marcobockelbrink/einfachstoppen-tor/docs/amazon.md

# Einkaufsliste (Suchlinks, keine Partnerlinks)

> **Es gibt hier keine Partnerlinks und es wird nichts daran verdient.** Die Links sind
> gewöhnliche Amazon-Suchen, damit man die Teile schneller findet. Wer sie nachbaut, kauft
> dort, wo er will.

Teile und Mengen: [teileliste.md](teileliste.md). Ich habe **keine einzelnen Produkte**
ausgewählt, weil ich Amazon-Seiten nicht abrufe und Preise, Händler und Verfügbarkeit
wechseln. Wähle je Zeile ein Angebot mit guten Bewertungen aus.

| Teil | Suchbegriff | Menge | Link |
| --- | --- | --- | --- |
| ESP32-C3 SuperMini | `ESP32-C3 SuperMini` | 2 | [suchen](https://www.amazon.de/s?k=ESP32-C3+SuperMini) |
| IR-Empfänger | `TSOP4838 IR Empfänger 38kHz` | 1 | [suchen](https://www.amazon.de/s?k=TSOP4838+IR+Empf%C3%A4nger+38kHz) |
| IR-LED 940 nm | `IR LED 940nm 5mm` | 1 | [suchen](https://www.amazon.de/s?k=IR+LED+940nm+5mm) |
| Transistor | `BC337 Transistor NPN` | 1 | [suchen](https://www.amazon.de/s?k=BC337+Transistor+NPN) |
| Widerstände | `Widerstand Sortiment 1/4W` | 1 Set | [suchen](https://www.amazon.de/s?k=Widerstand+Sortiment+1%2F4W) |
| Powerbank | `Powerbank klein 5000mAh` | 2 | [suchen](https://www.amazon.de/s?k=Powerbank+klein+5000mAh) |
| USB-C-Kabel kurz | `USB C Kabel 0,5m` | 2 | [suchen](https://www.amazon.de/s?k=USB+C+Kabel+0%2C5m) |
| Mutter 1/4″ | `Mutter 1/4 UNC 20 Stativ` | 2 | [suchen](https://www.amazon.de/s?k=Mutter+1%2F4+UNC+20+Stativ) |
| Blechschrauben | `Blechschrauben M3 Sortiment` | 1 Set | [suchen](https://www.amazon.de/s?k=Blechschrauben+M3+Sortiment) |
| Schrumpfschlauch | `Schrumpfschlauch schwarz 6mm` | 1 | [suchen](https://www.amazon.de/s?k=Schrumpfschlauch+schwarz+6mm) |
| Steckbrett und Jumperkabel | `Breadboard Jumper Kabel Set` | 1 | [suchen](https://www.amazon.de/s?k=Breadboard+Jumper+Kabel+Set) |
| Mini-Stativ | `Handy Stativ 1/4 Zoll` | 2 | [suchen](https://www.amazon.de/s?k=Handy+Stativ+1%2F4+Zoll) |

Für den Startstab ([startstab.md](startstab.md), Teile S2 bis S11):

| Teil | Suchbegriff | Menge | Link |
| --- | --- | --- | --- |
| Reedkontakt | `Reed Schalter Glas Schließer` | 1 | [suchen](https://www.amazon.de/s?k=Reed+Schalter+Glas+Schlie%C3%9Fer) |
| Scheibenmagnet | `Neodym Magnet Scheibe 8x3` | 1 | [suchen](https://www.amazon.de/s?k=Neodym+Magnet+Scheibe+8x3) |
| Rundstab | `Rundstab Holz 12mm` | 1 | [suchen](https://www.amazon.de/s?k=Rundstab+Holz+12mm) |
| Zugfeder | `Zugfeder Set klein` | 1 | [suchen](https://www.amazon.de/s?k=Zugfeder+Set+klein) |
| Holzschrauben | `Holzschrauben 3x20` | 1 Set | [suchen](https://www.amazon.de/s?k=Holzschrauben+3x20) |
| Scharnier | `Scharnier klein Edelstahl` | 1 | [suchen](https://www.amazon.de/s?k=Scharnier+klein+Edelstahl) |
| Sekundenkleber | `Sekundenkleber` | 1 | [suchen](https://www.amazon.de/s?k=Sekundenkleber) |

Die Suchbegriffe sind Vorschläge, nicht geprüft. Es lohnt sich, bei den Elektronikteilen
auch bei einem Elektronikhändler (z. B. Reichelt) zu schauen; dort ist das Datenblatt
meist verlinkt, was bei Sammelangeboten fehlt.
