marcobockelbrink/einfachstoppen-tor/gehaeuse/stl/stab_magnethalter.stl

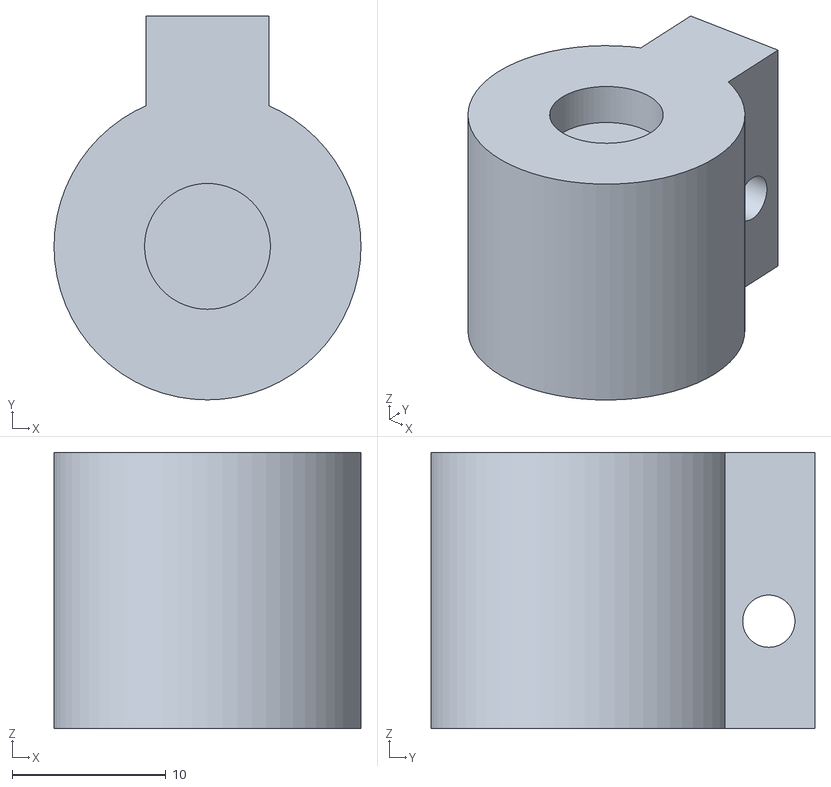
[picture p1: CAD file, 2026-10-12]
gehaeuse/stl/stab_magnethalter.stl
20.0 x 25.0 x 18.0
