marcobockelbrink/einfachstoppen-tor/gehaeuse/stl/stab_reedhalter.stl

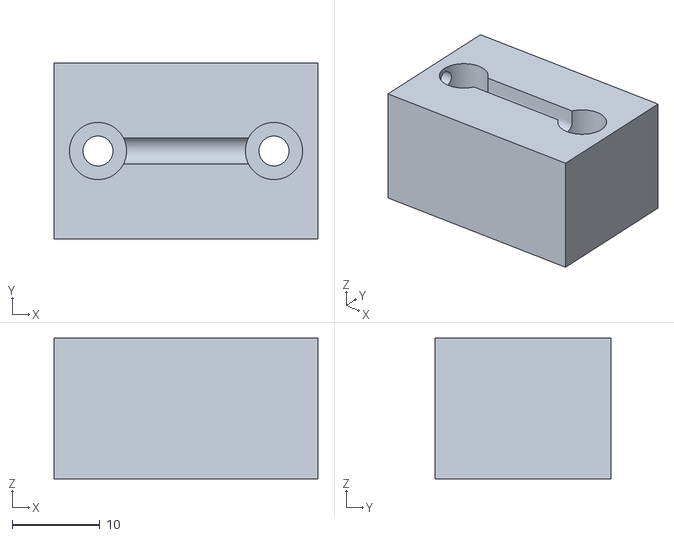
[picture p2: CAD file, 2026-10-12]
gehaeuse/stl/stab_reedhalter.stl
30.0 x 20.0 x 16.0
