marcobockelbrink/einfachstoppen-tor/gehaeuse/stl/stab_unten.stl

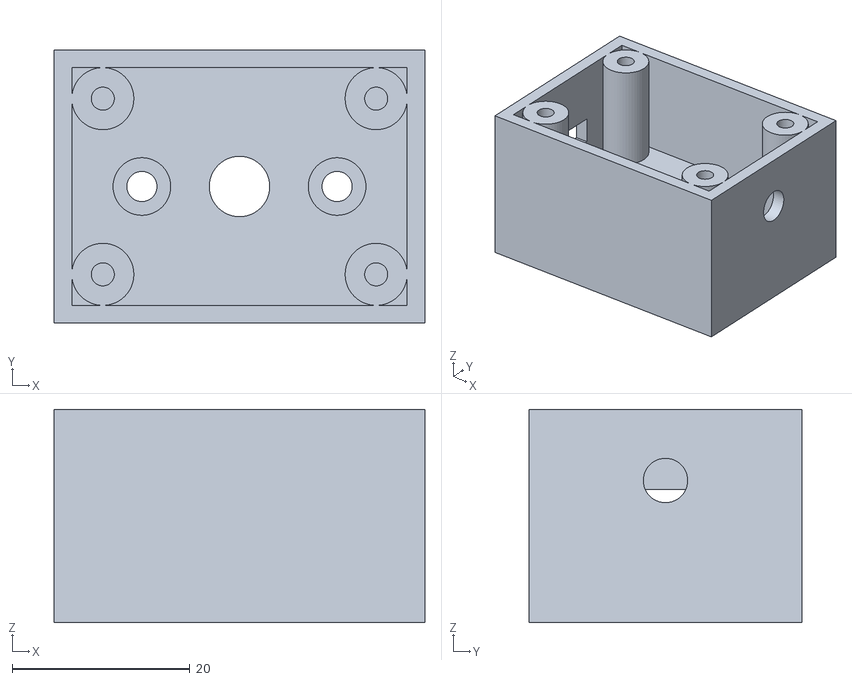
[picture p3: CAD file, 2026-10-12]
gehaeuse/stl/stab_unten.stl
41.8 x 30.8 x 24.0
