marcobockelbrink/einfachstoppen-tor/gehaeuse/stl/sender_deckel.stl

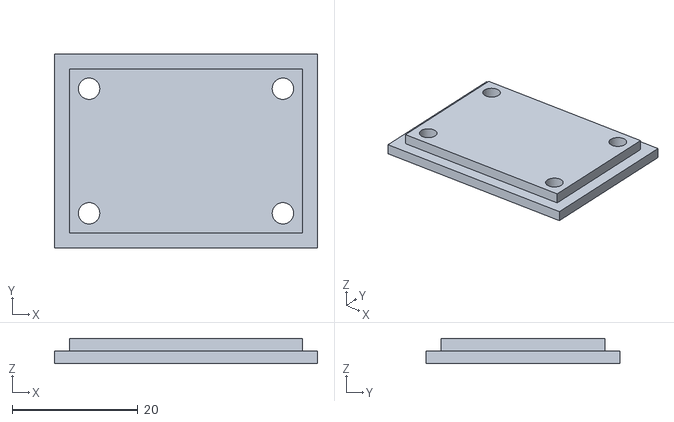
[picture p4: CAD file, 2026-10-12]
gehaeuse/stl/sender_deckel.stl
41.8 x 30.8 x 4.00
