marcobockelbrink/einfachstoppen-tor/(list of files, cad)

Other CAD files:
gehaeuse/stl/sender_unten.stl
gehaeuse/stl/tor_unten.stl
