marcobockelbrink/einfachstoppen-tor/(commit log)

2026-10-12 Tor: Lichtschranke mit ESP32-C3 und Bluetooth, Entwurf 0.1.0
    Firmware fuer Tor (Ziel und Start) und Sender, Kernlogik mit nativen Tests
    (Strahl-Abriss, Totzeit, Puffer, Pakete), Bluetooth-Protokoll, Architektur,
    Aufbauanleitung mit Bildern, Teileliste, Einkaufsliste, Gehaeuse in OpenSCAD.
    Nichts davon lief bisher auf Hardware; die Genauigkeit der Uhrenabstimmung
    ist ungemessen (docs/messung.md). Die Anbindung in der Kamera-App fehlt.
    [tor.scad]
2026-10-12 Doku: Anbindung in der Kamera-App gebaut (Release 0.3.0), Verweis auf die Checkliste
2026-10-12 Gehaeuse: STL-Dateien fuer Tor und Sender, aus tor.scad gerendert
    Claude-Session: https://claude.ai/code/session_01ATire5QvKtzhk8kLMWhcKR
    [sender_deckel.stl, sender_unten.stl, tor_deckel.stl, tor_unten.stl]
2026-10-12 Startstab: Reedkontakt-Modus, Doku, Bilder und Halter; Lizenzen (MIT, CERN-OHL-P-2.0, CC BY 4.0)
    Neuer TOR_MODUS=2 (tor::Kontakt) und Umgebung startstab. Das Oeffnen zaehlt nur nach
    mindestens 100 ms zu. docs/startstab.md mit drei Schaubildern, gehaeuse/stab.scad mit STL,
    Teileliste, Messung (Versuch 4) und Architektur ergaenzt. Amazon-Liste ohne Partnerlinks.
    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
    [stab.scad, stab_magnethalter.stl, stab_reedhalter.stl, stab_unten.stl, tor.scad]
2026-10-12 README: Link zur Anleitung auf einfachstoppen.de
    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
2026-10-13 Doku: Anbindung in der Kamera-App stimmt jetzt (Release 0.3.0, TestFlight-Beta), Schritt 7 im Aufbau nicht mehr 'noch nicht gebaut'
    Claude-Session: https://claude.ai/code/session_01Vp1bUWX8cCjX1Gvgvcafxn
2026-10-13 platformio.ini: Umgebung tor_modul fuer fertige Lichtschranke mit Open-Collector-Ausgang
    Modus 0, steigende Flanke, interner Pullup, GPIO 4. Baut fuer den ESP32-C3;
    am Geraet noch nicht ausprobiert.
